AberDerBart/garbage-keytar/README.md

# garbage-keytar

Code and design for a keytar made from an old PC keyboard
