AberDerBart/garbage-keytar/enclosure/parts.scad

module insert_m3() {
  translate([0,0,-5.7])cylinder(d=4,h=5.7+0.1);
}
