AberDerBart/garbage-keytar/kicad/keytar/keytar.kicad_pcb

## KiCad design kicad/keytar/keytar.kicad_pcb (2025-02-26)

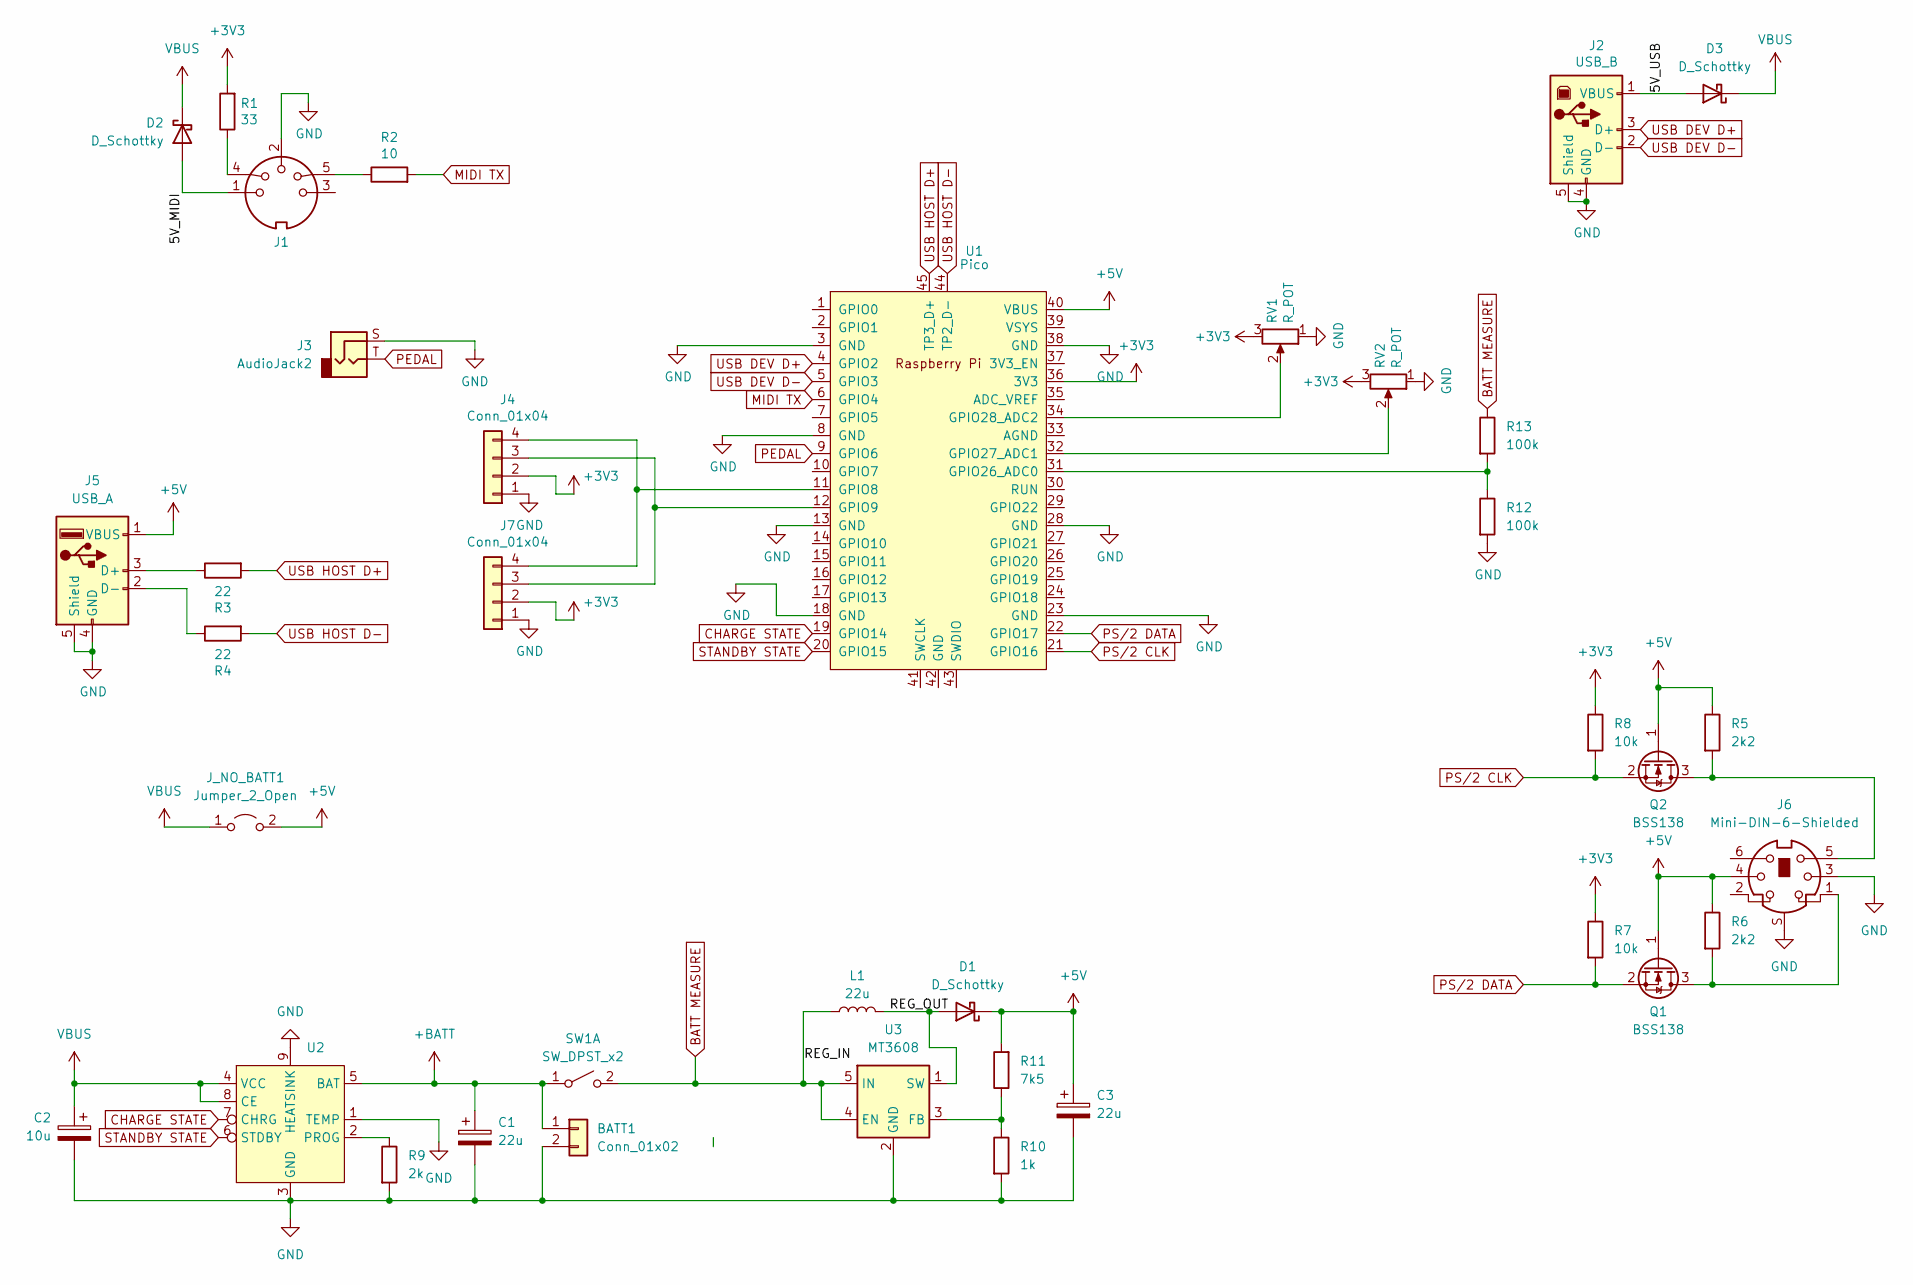
[picture p3: schematic keytar.kicad_sch]

Parts:
BATT1: Conn_01x02; JST_XH_B2B-XH-A_1x02_P2.50mm_Vertical
C1, C3: 22u; CP_Elec_4x5.3
C2: 10u; CP_Elec_4x5.3
D1, D2, D3: D_Schottky; D_SMA
J1: MIDI_DIN5
J2: USB_B; USB_B_OST_USB-B1HSxx_Horizontal
J3: AudioJack2; Jack_6.35mm_Neutrik_NRJ4HF_Horizontal
J4, J7: Conn_01x04; JST_XH_B4B-XH-A_1x04_P2.50mm_Vertical
J5: USB_A; USB_A_Molex_67643_Horizontal
J6: Mini-DIN-6-Shielded; EB-DIOS M06
J_NO_BATT1: Jumper_2_Open; SolderJumper-2_P1.3mm_Open_RoundedPad1.0x1.5mm
L1: 22u; L_Bourns-SRN4018
Q1, Q2: BSS138; SOT-23
R1: 33; R_1206_3216Metric_Pad1.30x1.75mm_HandSolder
R2: 10; R_1206_3216Metric_Pad1.30x1.75mm_HandSolder
R3, R4: 22; R_1206_3216Metric_Pad1.30x1.75mm_HandSolder
R5, R6: 2k2; R_1206_3216Metric_Pad1.30x1.75mm_HandSolder
R7, R8: 10k; R_1206_3216Metric_Pad1.30x1.75mm_HandSolder
R9: 2k; R_1206_3216Metric_Pad1.30x1.75mm_HandSolder
R10: 1k; R_1206_3216Metric_Pad1.30x1.75mm_HandSolder
R11: 7k5; R_1206_3216Metric_Pad1.30x1.75mm_HandSolder
R12, R13: 100k; R_1206_3216Metric_Pad1.30x1.75mm_HandSolder
RV1, RV2: R_POT; JST_XH_B3B-XH-A_1x03_P2.50mm_Vertical
SW1: SW_DPST_x2; JST_XH_B3B-XH-A_1x03_P2.50mm_Vertical
U1: Pico; RPi_Pico_debug_hole_USB_SMD_TH
U2: HSOP-8-1EP_3.9x4.9mm_P1.27mm_EP2.3x2.3mm
U3: MT3608; SOT-23-6

Connections:
+3V3: J4.2, J7.2, R1.2, R7.1, R8.1, RV1.3, RV2.3, U1.36 (3V3)
+5V: C3.1, D1.1 (K), J5.1 (VBUS), J6.4, J_NO_BATT1.2 (B), Q1.1 (G), Q2.1 (G), R5.1, R6.1, R11.2, U1.40 (VBUS)
+BATT: BATT1.1, C1.1, SW1.1 (A), U2.5 (BAT)
/5V_MIDI: D2.2 (A), J1.1
/5V_USB: D3.2 (A), J2.1 (VBUS)
/REG_OUT: D1.2 (A), L1.2, U3.1 (SW)
BATT MEASURE: L1.1, R13.1, SW1.2 (B), U3.4 (EN), U3.5 (IN)
CHARGE STATE: U1.19 (GPIO14), U2.7 (CHRG)
GND: BATT1.2, C1.2, C2.2, C3.2, J1.2, J2.4 (GND), J2.5 (Shield), J3.S, J4.1, J5.4 (GND), J5.5 (Shield), J6.3, J6.S, J7.1, R9.2, R10.2, R12.2, RV1.1, RV2.1, U1.3 (GND), U1.8 (GND), U1.13 (GND), U1.18 (GND), U1.23 (GND), U1.28 (GND), U1.38 (GND), U2.1 (TEMP), U2.3 (GND), U2.9 (HEATSINK), U3.2 (GND)
MIDI TX: R2.2, U1.6 (GPIO4)
unnamed: J1.4, R1.1
unnamed: J1.5, R2.1
unnamed: J4.3, J7.3, U1.12 (GPIO9)
unnamed: J4.4, J7.4, U1.11 (GPIO8)
unnamed: J5.3 (D+), R3.1
unnamed: J5.2 (D-), R4.1
unnamed: J6.1, Q1.3 (D), R6.2
unnamed: J6.5, Q2.3 (D), R5.2
unnamed: R12.1, R13.2, U1.31 (GPIO26_ADC0)
unnamed: RV2.2, U1.32 (GPIO27_ADC1)
unnamed: RV1.2, U1.34 (GPIO28_ADC2)
unnamed: R9.1, U2.2 (PROG)
unnamed: R10.1, R11.1, U3.3 (FB)
PEDAL: J3.T, U1.9 (GPIO6)
PS/2 CLK: Q2.2 (S), R8.2, U1.21 (GPIO16)
PS/2 DATA: Q1.2 (S), R7.2, U1.22 (GPIO17)
STANDBY STATE: U1.20 (GPIO15), U2.6 (STDBY)
USB DEV D+: J2.3 (D+), U1.4 (GPIO2)
USB DEV D-: J2.2 (D-), U1.5 (GPIO3)
USB HOST D+: R3.2, U1.45 (TP3_D+)
USB HOST D-: R4.2, U1.44 (TP2_D-)
VBUS: C2.1, D2.1 (K), D3.1 (K), J_NO_BATT1.1 (A), U2.4 (VCC), U2.8 (CE)

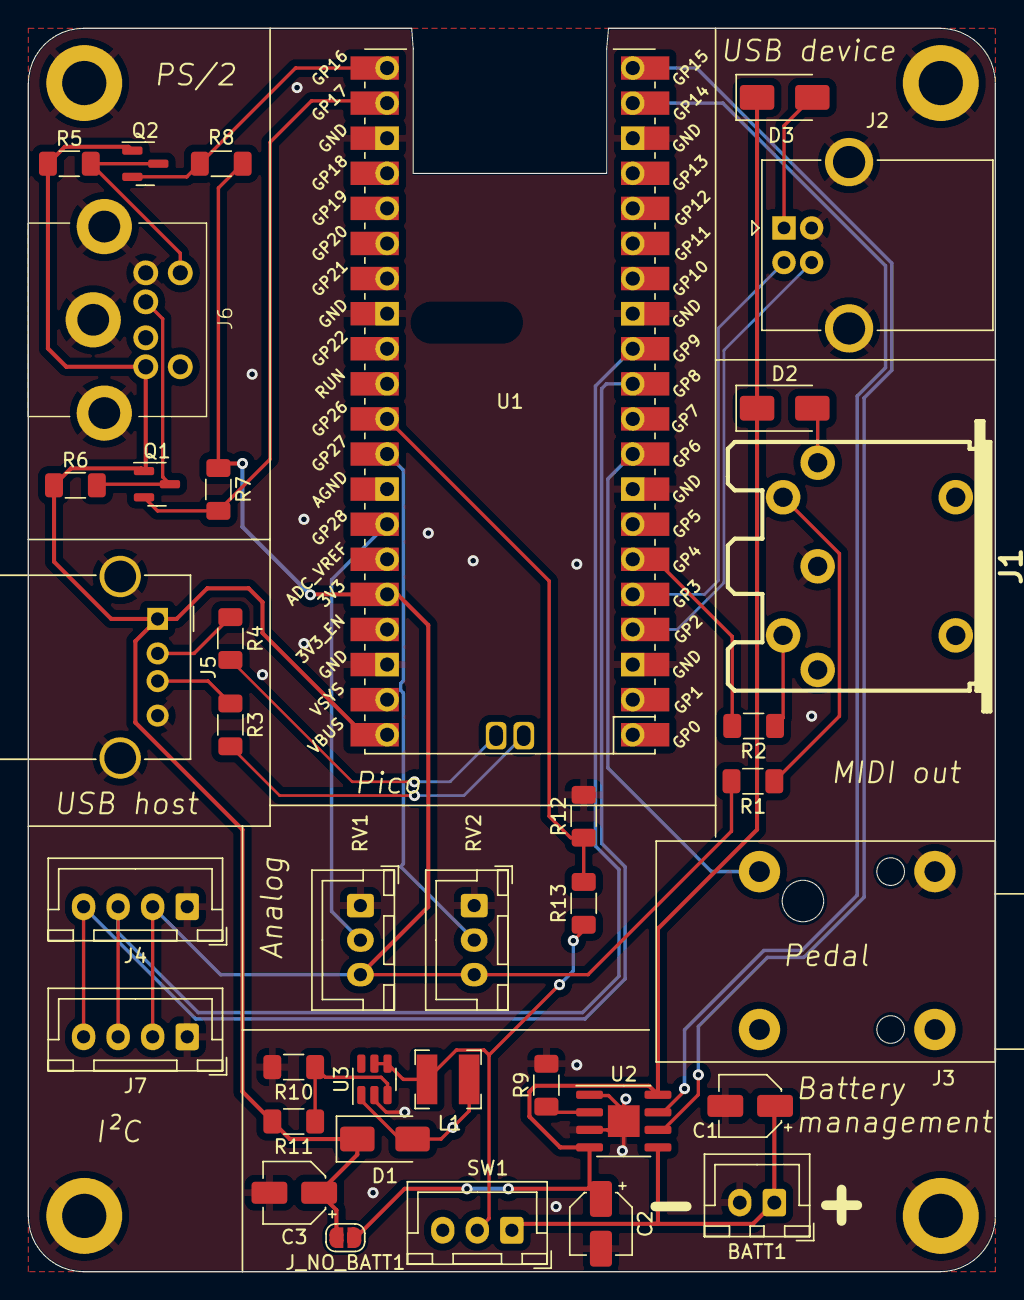
[picture p4: board keytar.kicad_pcb from above]

Board: 2 copper layers, 70.0 x 90.0 mm, 37 parts (0 on the bottom side), 32 nets.
