AberDerBart/garbage-keytar/firmware/main.c

/*
 * The MIT License (MIT)
 *
 * Copyright (c) 2019 Ha Thach (tinyusb.org)
 *
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
 */

#include <stdio.h>

#include "analog_strip.h"
#include "battery.h"
#include "config.h"
#include "display.h"
#include "keyboard.h"
#include "midi_ble.h"
#include "midi_uart.h"
#include "pico/stdio.h"
#include "midi_value.h"

extern void hid_task(void);

int main(void) {
  stdio_init_all();

  printf("---------\n");
  printf("startup\n");
  printf("---------\n");

  keyboard_init();

  midi_uart_init();
  battery_init();

  analog_strip_init();
  display_init();

  config_init();

  midi_ble_init();

  printf("all set up\n");

  while (1) {
    keyboard_task();

    analog_strip_read(&mv_pitchbend, true);
  }

  return 0;
}
