AberDerBart/garbage-keytar/firmware/keyboard_matrix.c

#include "keyboard_matrix.h"

#include <stddef.h>

#include "config.h"
#include "display.h"
#include "img/gen/accordion_b_32_16.h"
#include "img/gen/accordion_c_32_16.h"
#include "img/gen/guitar_32_16.h"
#include "img/gen/omnichord_32_16.h"
#include "img/gen/piano_32_16.h"
#include "img/gen/six_plus_six_32_16.h"
#include "img/gen/wicki_hayden_32_16.h"
#include "key_positions.h"
#include "ui/stack.h"

uint8_t note_by_lut(uint8_t keycode, uint8_t lut[4][14]) {
  if (keycode >= 128) {
    return 0;
  }
  int8_t row = keycode2row[keycode];
  int8_t col = keycode2column[keycode];

  if (row <= 0 || col < 0 || row > 4 || col >= 14) {
    return 0;
  }

  return lut[4 - row][col];
}

uint8_t note_by_pattern(uint8_t keycode, uint8_t offset, int8_t col_step,
                        int8_t row_step) {
  if (keycode >= 128) {
    return 0;
  }
  int8_t row = keycode2row[keycode];
  int8_t col = keycode2column[keycode];

  if (row < 0 || col < 0) {
    return 0;
  }

  return col * col_step + row * row_step + offset;
}

uint8_t piano_lut[4][14] = {
    {0, 0, 49, 51, 0, 54, 56, 58, 61, 63, 0, 66, 68, 0},
    {0, 48, 50, 52, 53, 55, 57, 59, 60, 62, 64, 65, 67, 69},
    {0, 0, 37, 39, 0, 42, 44, 46, 0, 49, 51, 0, 0, 0},
    {0, 36, 38, 40, 41, 43, 45, 47, 48, 50, 52, 0, 0, 0},
};

uint8_t* lookup_piano(uint8_t keycode) {
  static uint8_t notes[2] = {0, 0};
  notes[0] = note_by_lut(keycode, piano_lut);
  return notes;
}
keymap_t keymap_piano = {
  lookup : &lookup_piano,
  icon_size : piano_32_16_bmp_size,
  icon_data : piano_32_16_bmp_data,
  label : "Piano"
};

uint8_t* lookup_accordion_c(uint8_t keycode) {
  static uint8_t notes[2] = {0, 0};
  notes[0] = note_by_pattern(keycode, 36, 3, -2);
  return notes;
}
keymap_t keymap_accordion_c = {
  lookup : &lookup_accordion_c,
  icon_size : accordion_c_32_16_bmp_size,
  icon_data : accordion_c_32_16_bmp_data,
  label : "Acc. C"
};

uint8_t* lookup_accordion_b(uint8_t keycode) {
  static uint8_t notes[2] = {0, 0};
  notes[0] = note_by_pattern(keycode, 38, 3, -1);
  return notes;
}
keymap_t keymap_accordion_b = {
  lookup : &lookup_accordion_b,
  icon_size : accordion_b_32_16_bmp_size,
  icon_data : accordion_b_32_16_bmp_data,
  label : "Acc. B"
};

uint8_t* lookup_accordion_6plus6(uint8_t keycode) {
  static uint8_t notes[2] = {0, 0};
  notes[0] = note_by_pattern(keycode, 32, 2, -1);
  return notes;
}
keymap_t keymap_accordion_6plus6 = {
  lookup : &lookup_accordion_6plus6,
  icon_size : six_plus_six_32_16_bmp_size,
  icon_data : six_plus_six_32_16_bmp_data,
  label : "6 + 6"
};

uint8_t* lookup_wicki_hayden(uint8_t keycode) {
  static uint8_t notes[2] = {0, 0};
  notes[0] = note_by_pattern(keycode, 32, 2, 7);
  return notes;
}
keymap_t keymap_wicki_hayden = {
  lookup : &lookup_wicki_hayden,
  icon_size : wicki_hayden_32_16_bmp_size,
  icon_data : wicki_hayden_32_16_bmp_data,
  label : "W/H"
};

uint8_t* lookup_guitar(uint8_t keycode) {
  static uint8_t notes[2] = {0, 0};
  notes[0] = note_by_pattern(keycode, 40, 1, 5);
  return notes;
}
keymap_t keymap_guitar = {
  lookup : &lookup_guitar,
  icon_size : guitar_32_16_bmp_size,
  icon_data : guitar_32_16_bmp_data,
  label : "Guitar"
};

keymap_t* keymap = &keymap_piano;

uint8_t* lookup_omnichord(uint8_t keycode) {
  static uint8_t notes[5] = {0, 0, 0, 0, 0};

  int8_t row = keycode2row[keycode];
  int8_t col = keycode2column[keycode];

  if (row < 0 || col < 0) {
    notes[0] = 0;
    return notes;
  }

  notes[0] = 40 + ((col * 7) % 12);
  switch (row) {
    case 1:
      notes[1] = notes[0] + 4;
      notes[2] = notes[0] + 7;
      notes[3] = notes[0] + 10;
      notes[4] = 0;
      break;
    case 2:
      notes[1] = notes[0] + 3;
      notes[2] = notes[0] + 7;
      notes[3] = 0;
      break;
    case 3:
      notes[1] = notes[0] + 4;
      notes[2] = notes[0] + 7;
      notes[3] = 0;
      break;
    case 4:
    default:
      notes[1] = 0;
  }
  return notes;
}

keymap_t keymap_omnichord = {
  lookup : &lookup_omnichord,
  icon_size : omnichord_32_16_bmp_size,
  icon_data : omnichord_32_16_bmp_data,
  label : "Omnichord"
};

void set_keymap(keymap_t* new_keymap) {
  keymap = new_keymap;
  ui_render();
}

keymap_t* keymap_get() { return keymap; }

keymap_t* keymaps[N_KEYMAPS + 1] = {&keymap_piano,        &keymap_accordion_c,
                                &keymap_accordion_b,  &keymap_accordion_6plus6,
                                &keymap_wicki_hayden, &keymap_guitar,
                                &keymap_omnichord, NULL};

size_t get_n_keymaps() { return N_KEYMAPS; }

size_t get_keymap_index() {
  for (size_t i = 0; i < N_KEYMAPS; i++) {
    if (keymap == keymaps[i]) {
      return i;
    }
  }
  return 0;
}

void set_keymap_by_index(size_t index) {
  if (index >= N_KEYMAPS) {
    return;
  }

  set_keymap(keymaps[index]);
}
