AberDerBart/garbage-keytar/firmware/key_positions.h

#pragma once
#include <stdint.h>

int8_t const keycode2row[128] = {
    -1, /* 0x00 */
    -1, /* 0x01 */
    -1, /* 0x02 */
    -1, /* 0x03 */
    2,  /* 0x04 a */
    1,  /* 0x05 b */
    1,  /* 0x06 c */
    2,  /* 0x07 d */
    3,  /* 0x08 e */
    2,  /* 0x09 f */
    2,  /* 0x0a g */
    2,  /* 0x0b h */
    3,  /* 0x0c i */
    2,  /* 0x0d j */
    2,  /* 0x0e k */
    2,  /* 0x0f l */
    1,  /* 0x10 m */
    1,  /* 0x11 n */
    3,  /* 0x12 o */
    3,  /* 0x13 p */
    3,  /* 0x14 q */
    3,  /* 0x15 r */
    2,  /* 0x16 s */
    3,  /* 0x17 t */
    3,  /* 0x18 u */
    1,  /* 0x19 v */
    3,  /* 0x1a w */
    1,  /* 0x1b x */
    3,  /* 0x1c y */
    1,  /* 0x1d z */
    4,  /* 0x1e 1 */
    4,  /* 0x1f 2 */
    4,  /* 0x20 3 */
    4,  /* 0x21 4 */
    4,  /* 0x22 5 */
    4,  /* 0x23 6 */
    4,  /* 0x24 7 */
    4,  /* 0x25 8 */
    4,  /* 0x26 9 */
    4,  /* 0x27 0 */
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
    -1, /* 0x2c SPACE */
    -1, /* 0x2d - */
    4,  /* 0x2e = */
    3,  /* 0x2f [ */
    3,  /* 0x30 ] */
    -1, /* 0x31 \ */
    1,  /* 0x32 # */
    2,  /* 0x33 ; */
    2,  /* 0x34 ' */
    4,  /* 0x35 ` */
    1,  /* 0x36 , */
    1,  /* 0x37 . */
    1,  /* 0x38 / */
    -1, /* 0x39 */
    -1, /* 0x3a */
    -1, /* 0x3b */
    -1, /* 0x3c */
    -1, /* 0x3d */
    -1, /* 0x3e */
    -1, /* 0x3f */
    -1, /* 0x40 */
    -1, /* 0x41 */
    -1, /* 0x42 */
    -1, /* 0x43 */
    -1, /* 0x44 */
    -1, /* 0x45 */
    -1, /* 0x46 */
    -1, /* 0x47 */
    -1, /* 0x48 */
    -1, /* 0x49 */
    -1, /* 0x4a */
    -1, /* 0x4b */
    -1, /* 0x4c */
    -1, /* 0x4d */
    -1, /* 0x4e */
    -1, /* 0x4f */
    -1, /* 0x50 */
    -1, /* 0x51 */
    -1, /* 0x52 */
    -1, /* 0x53 */
    -1, /* 0x54 / */
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
    1,  /* 0x64 < (german) */
    -1, /* 0x67 = */
    -1, -1, -1, -1, -1, -1, -1, -1, -1, -1, -1, -1, -1,
    -1, -1, -1, -1, -1, -1, -1, -1, -1, -1, -1, -1, -1,
};

int8_t const keycode2column[128] = {
    -1, /* 0x00 */
    -1, /* 0x01 */
    -1, /* 0x02 */
    -1, /* 0x03 */
    1,  /* 0x04 a */
    5,  /* 0x05 b */
    3,  /* 0x06 c */
    3,  /* 0x07 d */
    3,  /* 0x08 e */
    4,  /* 0x09 f */
    5,  /* 0x0a g */
    6,  /* 0x0b h */
    8,  /* 0x0c i */
    7,  /* 0x0d j */
    8,  /* 0x0e k */
    9,  /* 0x0f l */
    7,  /* 0x10 m */
    6,  /* 0x11 n */
    9,  /* 0x12 o */
    10, /* 0x13 p */
    1,  /* 0x14 q */
    4,  /* 0x15 r */
    2,  /* 0x16 s */
    5,  /* 0x17 t */
    7,  /* 0x18 u */
    4,  /* 0x19 v */
    2,  /* 0x1a w */
    2,  /* 0x1b x */
    6,  /* 0x1c y */
    1,  /* 0x1d z */
    1,  /* 0x1e 1 */
    2,  /* 0x1f 2 */
    3,  /* 0x20 3 */
    4,  /* 0x21 4 */
    5,  /* 0x22 5 */
    6,  /* 0x23 6 */
    7,  /* 0x24 7 */
    8,  /* 0x25 8 */
    9,  /* 0x26 9 */
    10, /* 0x27 0 */
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
    -1, /* 0x2c SPACE */
    11, /* 0x2d - */
    12, /* 0x2e = */
    11, /* 0x2f [ */
    12, /* 0x30 ] */
    13, /* 0x31 \ */
    11, /* 0x32 # */
    10, /* 0x33 ; */
    11, /* 0x34 ' */
    0,  /* 0x35 ` */
    8,  /* 0x36 , */
    9,  /* 0x37 . */
    10, /* 0x38 / */
    -1, /* 0x39 */
    -1, /* 0x3a */
    -1, /* 0x3b */
    -1, /* 0x3c */
    -1, /* 0x3d */
    -1, /* 0x3e */
    -1, /* 0x3f */
    -1, /* 0x40 */
    -1, /* 0x41 */
    -1, /* 0x42 */
    -1, /* 0x43 */
    -1, /* 0x44 */
    -1, /* 0x45 */
    -1, /* 0x46 */
    -1, /* 0x47 */
    -1, /* 0x48 */
    -1, /* 0x49 */
    -1, /* 0x4a */
    -1, /* 0x4b */
    -1, /* 0x4c */
    -1, /* 0x4d */
    -1, /* 0x4e */
    -1, /* 0x4f */
    -1, /* 0x50 */
    -1, /* 0x51 */
    -1, /* 0x52 */
    -1, /* 0x53 */
    -1, /* 0x54 / */
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
    -1, /* 0x64 < (german) */
    -1, /* 0x67 = */
    -1, -1, -1, -1, -1, -1, -1, -1, -1, -1, -1, -1, -1,
    -1, -1, -1, -1, -1, -1, -1, -1, -1, -1, -1, -1, -1,
};
