AberDerBart/garbage-keytar/firmware/midi_note_table.h

#include <stdint.h>
uint8_t const keycode2midi[128] = {
    0,  /* 0x00 */
    0,  /* 0x01 */
    0,  /* 0x02 */
    0,  /* 0x03 */
    0,  /* 0x04 a */
    43, /* 0x05 b */
    40, /* 0x06 c */
    39, /* 0x07 d */
    52, /* 0x08 e */
    0,  /* 0x09 f */
    42, /* 0x0a g */
    44, /* 0x0b h */
    60, /* 0x0c i */
    46, /* 0x0d j */
    0,  /* 0x0e k */
    49, /* 0x0f l */
    47, /* 0x10 m */
    45, /* 0x11 n */
    62, /* 0x12 o */
    64, /* 0x13 p */
    48, /* 0x14 q */
    53, /* 0x15 r */
    37, /* 0x16 s */
    55, /* 0x17 t */
    59, /* 0x18 u */
    41, /* 0x19 v */
    50, /* 0x1a w */
    38, /* 0x1b x */
    57, /* 0x1c y */
    36, /* 0x1d z */
    0,  /* 0x1e 1 */
    49, /* 0x1f 2 */
    51, /* 0x20 3 */
    0,  /* 0x21 4 */
    54, /* 0x22 5 */
    56, /* 0x23 6 */
    58, /* 0x24 7 */
    0,  /* 0x25 8 */
    61, /* 0x26 9 */
    63, /* 0x27 0 */
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
    0,  /* 0x2c SPACE */
    0,  /* 0x2d - */
    66, /* 0x2e = */
    65, /* 0x2f [ */
    67, /* 0x30 ] */
    0,  /* 0x31 \ */
    53, /* 0x32 # */
    51, /* 0x33 ; */
    0,  /* 0x34 ' */
    0,  /* 0x35 ` */
    48, /* 0x36 , */
    50, /* 0x37 . */
    52, /* 0x38 / */
    0,  /* 0x39 */
    0,  /* 0x3a */
    0,  /* 0x3b */
    0,  /* 0x3c */
    0,  /* 0x3d */
    0,  /* 0x3e */
    0,  /* 0x3f */
    0,  /* 0x40 */
    0,  /* 0x41 */
    0,  /* 0x42 */
    0,  /* 0x43 */
    0,  /* 0x44 */
    0,  /* 0x45 */
    0,  /* 0x46 */
    0,  /* 0x47 */
    0,  /* 0x48 */
    0,  /* 0x49 */
    0,  /* 0x4a */
    0,  /* 0x4b */
    0,  /* 0x4c */
    0,  /* 0x4d */
    0,  /* 0x4e */
    0,  /* 0x4f */
    0,  /* 0x50 */
    0,  /* 0x51 */
    0,  /* 0x52 */
    0,  /* 0x53 */
    0,  /* 0x54 / */
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
    35, /* 0x64 < (german) */
    0,  /* 0x67 = */
    0,  0, 0, 0, 0, 0, 0, 0, 0, 0, 0, 0, 0,
    0,  0, 0, 0, 0, 0, 0, 0, 0, 0, 0, 0, 0,
};
