AberDerBart/garbage-keytar/(commit log)

2021-04-24 cad numblock cover
    [numblock_cover.scad]
2021-04-24 add makefile
    [picoprobe.cfg, rp2040.cfg]
2021-06-13 improve case
    [keyboard_cover.scad, numblock_cover.scad, single-key_cover.scad]
2021-08-19 use pico-sdk in submodule
2021-08-19 add pcb
    [keytar.kicad_pcb, keytar.sch]
2021-09-05 add pico-ssd1306 submodule
2021-09-05 properly implement PCB
    [keytar.kicad_pcb, keytar.sch]
2021-09-05 ignore gerber files
2021-09-05 fix shell.nix, pin nixpkgs
2021-10-26 add power via MIDI to pcb
    [keytar.kicad_pcb, keytar.sch]
2023-10-01 migrate to flakes and vscode
    [picoprobe.cfg, rp2040.cfg]
2023-10-01 fix arrow keys causing midi notes
    [main.c, midi.c]
2023-10-03 upgrade pico sdk
2024-01-03 add enclosure
    [case.scad, keyboard.scad, parts.scad, pcb.scad]
2024-01-03 adjust keyboard dimensions
    [keyboard.scad]
2024-01-03 adjust cable channel
    [case.scad]
2024-01-03 increase cable box size
    [case.scad]
2024-01-03 add wiggleroom for pedal connector
    [pcb.scad]
2024-01-03 add space for support strips
    [case.scad]
2024-01-03 fine-tune keyboard dimensions
    [keyboard.scad]
2024-01-03 add right half of case
    [case.scad, keyboard.scad]
2024-01-03 case finishing touches
    [case.scad, pcb.scad]
2024-01-03 enclosure: split top and bottom pieces
    [case.scad]
2024-01-03 redesign pcb
    [keytar.kicad_pcb, keytar.kicad_sch]
2024-01-03 shrink PCB, add USB and PS/2 ports
    [keytar.kicad_pcb, keytar.kicad_sch]
2024-01-03 add battery management
    [keytar.kicad_pcb, keytar.kicad_sch]
2024-01-03 adjust midi pin
    [keytar.kicad_pcb, keytar.kicad_sch]
2024-01-03 route board
    [keytar.kicad_pcb, keytar.kicad_sch]
2024-01-03 improve pcb
    [keytar.kicad_pcb, keytar.kicad_sch]
2024-01-03 kicad: finalize pcb design for order
    [keytar.kicad_pcb]
2024-03-14 remove old casemod
    [keyboard_cover.scad, numblock_cover.scad, single-key_cover.scad]
2024-03-14 make discoverable midi device
2024-03-14 add pico-w-ble-midi-lib
2024-03-14 display: handle missing display
    [display.c]
2024-03-14 firmware: try to fix deadlock
    [keyboard.c, midi_ble.c]
2024-03-14 revert to hardware USB host
    [keyboard.c, main.c, midi_ble.c, tusb_config.h]
2024-03-14 fix pico-ssd1306 submodule
2024-03-14 fix pico-sdk submodule
2024-03-14 fix keyboard debug messages
    [keyboard.c]
2024-03-14 WIP: redesign display
    TODO: adjust build pipeline
    TODO: reintegrate transposition and instrument display
    [display.c, keyboard.c, main.c, midi_ble.c]
2024-03-14 fix uart midi pin (code only)
    [midi_uart.c]
2024-07-30 firmware: fix # key
    [midi_note_table.h]
2024-08-04 firmware: fix . and , key swap
    [key_positions.h, midi_note_table.h]
2024-08-04 fix offset for chromatic keyboards
    [keyboard_matrix.c]
2024-08-04 firmware: implement key layout switch
2024-09-19 create debug case
    [battery_cover.scad, case.scad, constants.scad, display.scad, mounting_holes.scad]
2024-09-19 add case for switch
    [case.scad]
2024-09-19 adjust display window
    [display.scad]
2024-09-19 add traces to read charger status
    [keytar.kicad_pcb, keytar.kicad_sch]
2024-09-19 kicad: use proper capacitors
    [keytar.kicad_pcb, keytar.kicad_sch]
2024-09-19 pcb: adjust midi and pedal pins
    [keytar.kicad_pcb, keytar.kicad_sch]
2024-09-19 pcb: switch usb device and host pins
    [keytar.kicad_pcb, keytar.kicad_sch]
2024-09-20 case: add captive nuts for strap mounts
    [captive_nut.scad, case.scad]
2025-01-05 enclosure: WIP extract head to own file
    [case.scad, constants.scad, head.scad, pitch_wheel.scad]
2025-01-06 firmware: list BLE MIDI devices in menu
2025-01-06 firmware: implement connecting to bluetooth devices
2025-01-12 firmware: activate and fix pitchbend
    [main.c, midi.h, pitchbend.c]
2025-02-21 enclosure: add neck
    [head.scad, neck.scad]
2025-02-26 kicad: add voltage divider for battery voltage measurement
    [keytar.kicad_pcb, keytar.kicad_sch]
2025-03-03 firmware: implement battery state display
2025-03-05 firmware: add histeresis to battery display
2025-03-10 firmware: fix guitar and piano keymaps
    [display.c, keyboard_matrix.c]
2025-03-10 firmware: adjust battery threshold
2025-03-12 firmware: fix ble display for client mode
    [display.c, midi_ble.c, midi_ble.h]
2025-08-17 implement basic profiles
    currently only properly support envelopes
2026-07-12 ignore kicad history
2026-07-22 firmware: fix bluetooth menu
    [bluetooth.c]
2026-07-25 re-send pitch bend value if sending fails
    [midi.c, midi.h, midi_ble.c, midi_ble.h, midi_ble_client.c, midi_ble_client.h, midi_uart.c]
